rejunity/tt07-analog-dac-ay8913/docs/info.md

<!---

This file is used to generate your project datasheet. Please fill in the information below and delete any unused
sections.

You can also include images in this folder and reference them in the markdown. Each image must be less than
512 kb in size, and the combined size of all images must be less than 1 MB.
-->

## How it works

Current steering DAC.

## How to test

Set one of the input / bidir pins to regulate current.

## External hardware

Measure with osciloscope or use amplifier and speakers.
