rejunity/tt07-analog-dac-ay8913/(commit log)

2024-05-17 logarithmic DAC schematics and symbol
    [dac_16nfet.sch]
2024-05-20 logarithmic DAC however it maxouts at 600uA instea of 2000uA
    [dac_16nfet.sch]
2024-05-21 remade DAC with LVT transistors, resized and added testbench
    [dac_16nfet.sch, testbench_dac_16nfet.sch]
2024-05-23 wired up DAC to TT pins
2024-05-23 Parasytics extracted
    [testbench_dac_16nfet.sch]
